CBrownUTT/American-Sign-Language-Translation-Glove/modelWrapperBLE/BLE Output Program/ASL_Signs/L.png

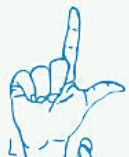
modelWrapperBLE/BLE Output Program/ASL_Signs/L.png
