CBrownUTT/American-Sign-Language-Translation-Glove/modelWrapperBLE/BLE Output Program/ASL_Signs/G.png

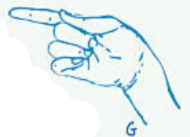
modelWrapperBLE/BLE Output Program/ASL_Signs/G.png
