CBrownUTT/American-Sign-Language-Translation-Glove/Docs/Wearable Glove for American Sign Language (ASL) Gesture Recognition - FDP.pdf

## Final Design Presentation For Wearable Glove for American Sign Language (ASL) Gesture Recognition

### Jalen Bell, Chase Brown, Jared Carrig

### Outline

1. Initial Problem & Motivation
2. Objective & Requirements
3. System Overview
4. Hardware Design
5. Software & Machine Learning
6. Design Constraints & Ethical Considerations
7. Testing Methodology
8. Results
9. Analysis
10. Limitations
11. Future Work
12. Conclusion
13. Acknowledgments
14. References

### Initial Problem & Motivation

- Sign language use is a key marker for those enculturated into a deaf community [1]
- Socioculturally distinguishes being deaf from being hard of hearing [1]
- According to a NHIS survey, 2.80% of Americans use ASL [1]
- The same survey 16.12% of Americans report little to immense trouble with hearing
- The Wearable Glove for ASL Gesture Recognition serves as an effective, low-cost solution to this marginalized group of ASL users

### Objectives & Requirements

- Design a portable prototype to function in real-time whilst identifying ASL gestures
- Integrate sensors to interact with an embedded system
- The glove should translate the ASL alphabet and numbers one through ten
- Require that the system predict gestures with > 90% accuracy
- Comply with ethical safety factors
- Battery safety
- Make predictions within 65ms
- Maintain low cost

### System Overview

- Novel use of sensors pose as a benefit to many different kinds of systems
- “Wearable Glove for American Sign Language (ASL) Gesture Recognition,” works as a solution to translating ASL for a larger audience
- Three different sensory subsystems implemented with a microcontroller using a lightweight model
- The microcontroller displays model predictions via BLE using an application

System Overview (Sensors) ● Three different sensor subsystems to

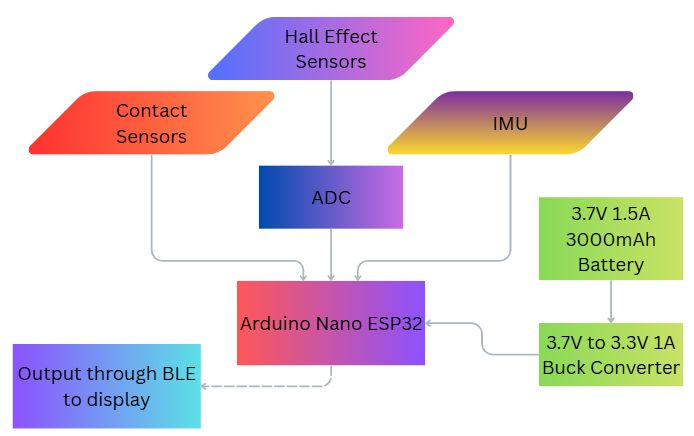
[picture p3: figure]

determine ○ Bend of the finger ○ Position of the wrist ○ Contact between finger tips

- Sensory data is acquired and handled by a microcontroller
- Performs real-time analysis of sensory data using a lightweight model
- A program interacts via BLE capabilities of the microcontroller

### Overview of Hardware Subsystems ● Contact Sensor

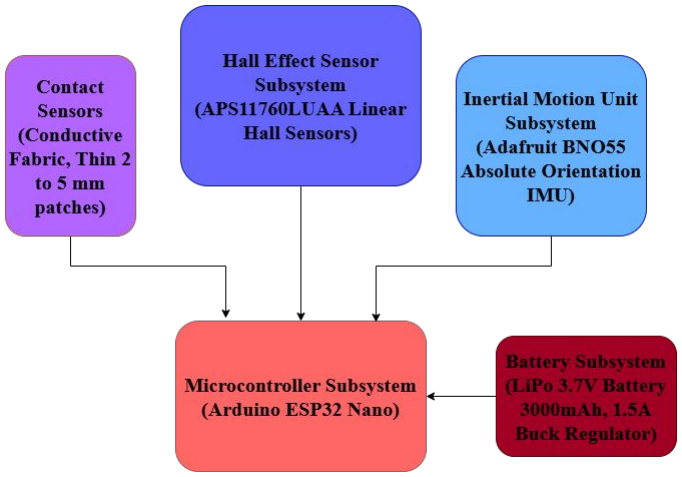
[picture p4: figure]

Subsystem
- Hall Effect Sensors
(Finger Bend)
Subsystem
- Inertial Motion Unit
Subsystem
- Microcontroller
Subsystem
- Battery/Power
Subsystem

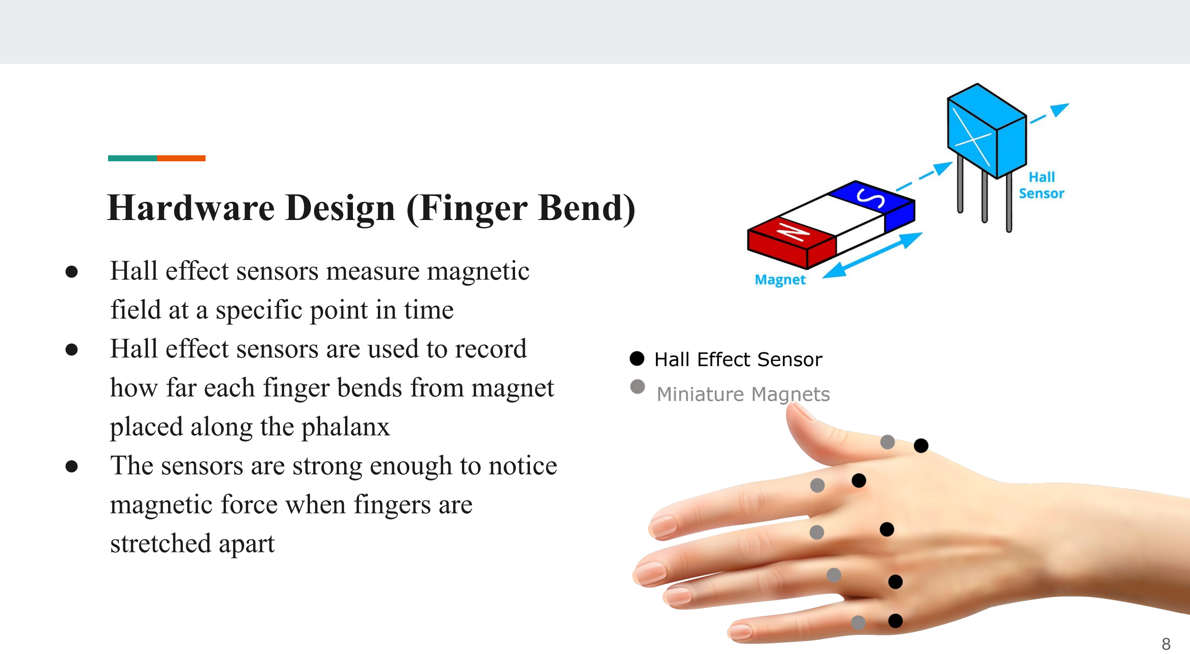
[picture p5: page 8]

### Hardware Design (Finger Bend)

- Hall effect sensors measure magnetic
field at a specific point in time
- Hall effect sensors are used to record how far each finger bends from magnet placed along the phalanx
- The sensors are strong enough to notice magnetic force when fingers are stretched apart

### Hardware Design (Contact Points)

- The glove requires that certain finger contacts to increase accuracy
- Sensors are placed along the:
- Index tip
- Middle finger tip
- Thumb (3.3V)
- Index Rear (3.3V)
- Palm
- Under the middle finger

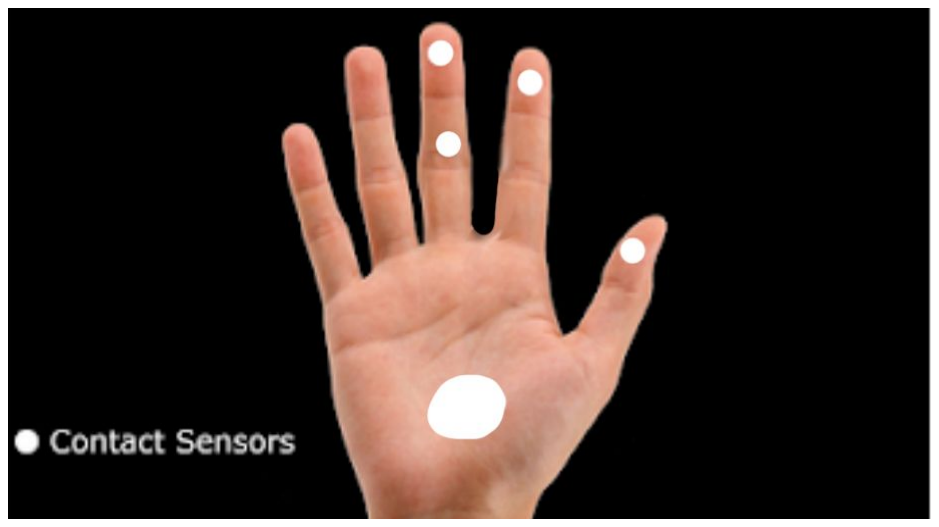
[picture p6: figure]

- Examples of gestures affected: ‘E’, ‘F’, ‘N’, ‘O’, ‘R’,

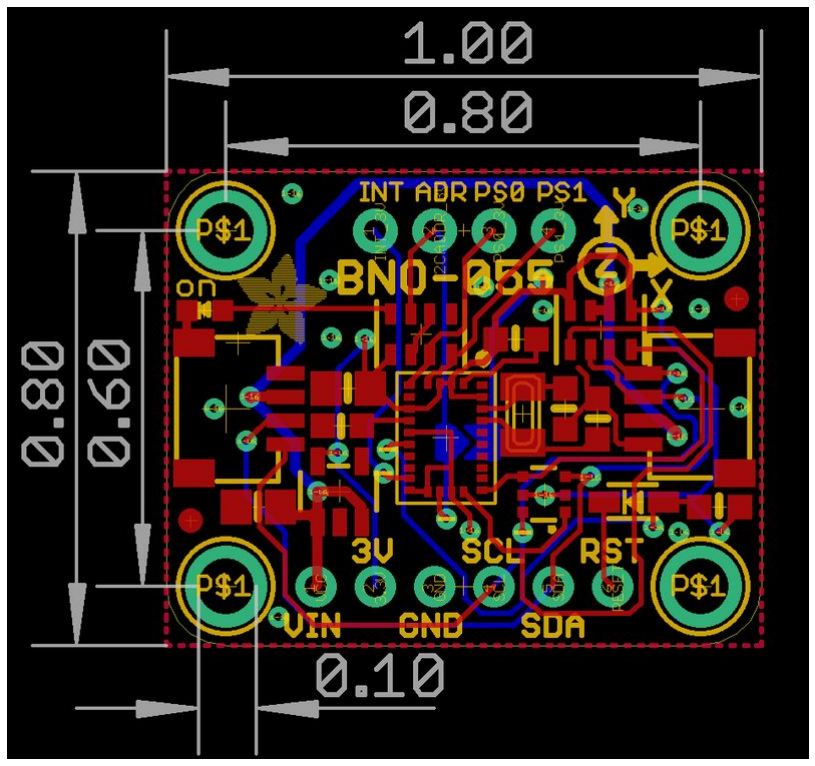
[picture p7: figure]

Hardware Design (Movement) ● | Nine Degrees of Freedom ○ | Accelerometer detects acceleration

for identifying dynamic gestures
- | Gyroscope measures orientation ■ | For example, distinguishes
| | similar gestures such as ‘V’ and ‘2’
- Magnetometer measures speed of the glove to aid in dynamic gesture recognition
- Sends data through SDA

### Power Note

- A 3.7V LiPo (3000 mAh) battery with a buck converter is used to directly power the ESP32
- Another option is powering with 5V via USB-C
- 4 - 6 hours of estimated battery life

### Evaluation of Alternatives

### - Hardware alternatives considered in Top-Level System Architecture - Considered cost, power, speed, wearability, and manufacturability - Safety/Welfare weighed higher to ensure safety of the user - Cultural factors weighed high to ensure to offense is posed to ASL users

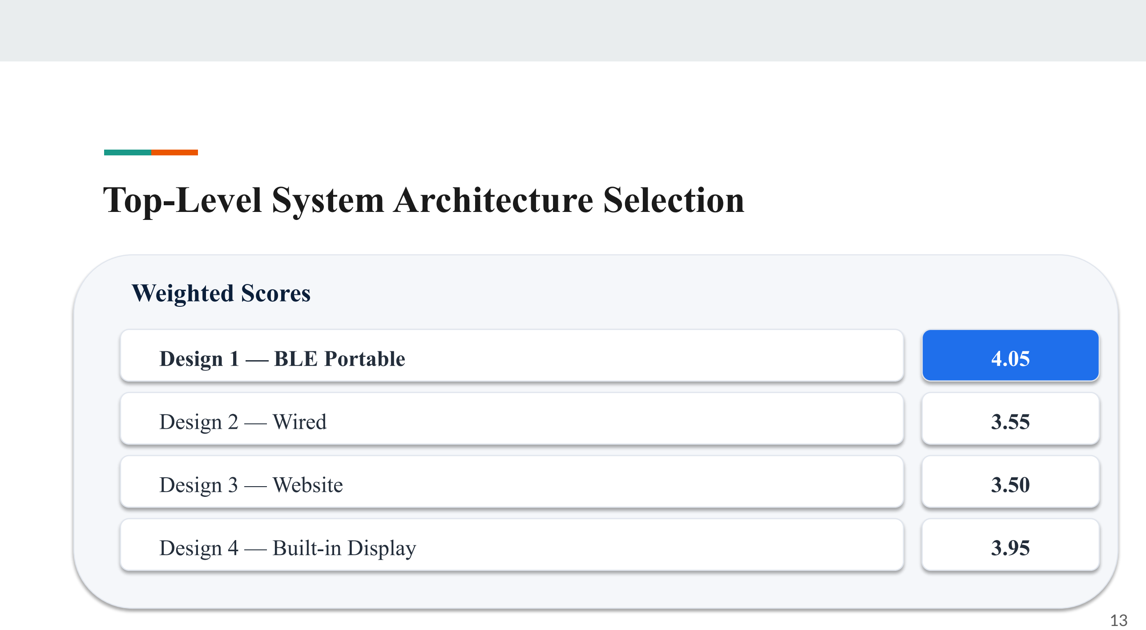
[picture p8: page 13]

### Top-Level System Architecture Selection

Weighted Scores

Design 1 — BLE Portable | 4.05
Design 2 — Wired | 3.55
Design 3 — Website | 3.50
Design 4 — Built-in Display | 3.95

### Top-Level System Architecture (cont.)

- The weighted evaluation above shows the Wearable and Portable Glove with BLE Applications maximize:
- Safety of the user
- Clear predictions of gestures
- Support for end-of-life disposal
- Minimizes cost
- Supports ASL communities
- Note: BLE applications can easily be reworked into an app that can translate into alternative languages while a display limits the translation capabilities.
- Design four has the closest score to the first design and offers a competent alternative

### Subsystem Architecture Selection

- Weighted decision matrices used to determine best component for each subsystem - Optimized on different parameters for each matrix - Microcontroller: Cost, Complexity, Compactness - Finger-bend Sensor: Accuracy, Durability - IMU: Compatibilty, Redundance - Contact Pads: Compatibility, Accessibility

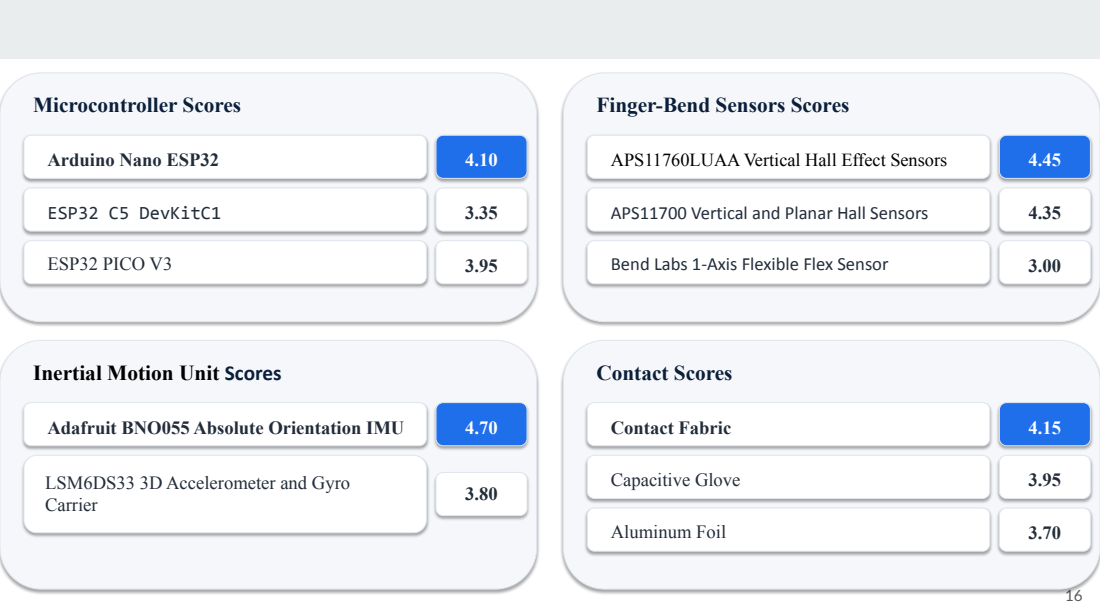
[picture p9: page 16]
Microcontroller Scores; Arduino Nano ESP32; ESP32 C5 DevKitC1; ESP32 PICO V3; Adafruit BNO055 Absolute Orientation IMU; Carrier; APS11760LUAA Vertical Hall Effect Sensors; APS11700 Vertical and Planar Hall Sensors; Bend Labs 1-Axis Flexible Flex Sensor; Contact Scores; Contact Fabric; Capacitive Glove; Aluminum Foil

Finger-Bend Sensors Scores

Inertial Motion Unit Scores

LSM6DS33 3D Accelerometer and Gyro

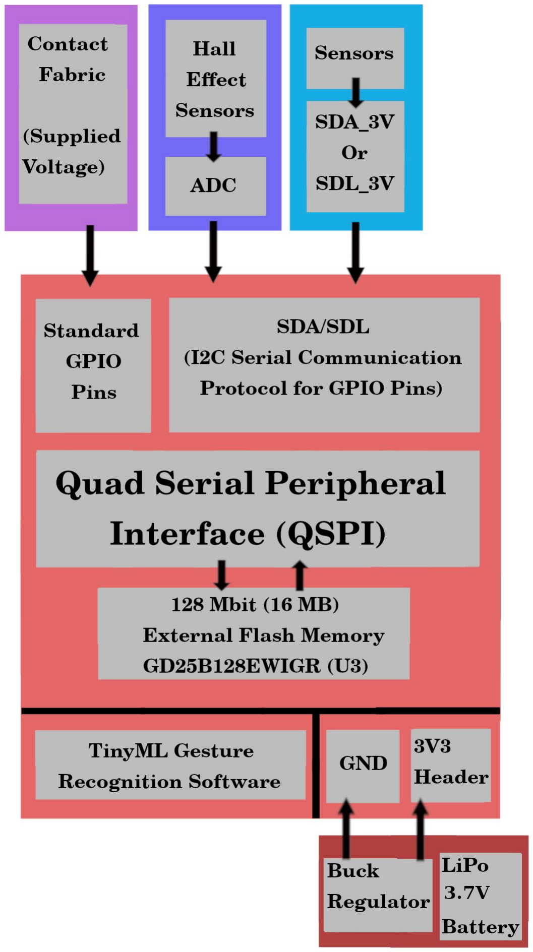
[picture p10: figure]

Hardware Block Diagram ● The hall effect sensors interact with the ADC

within their own subsystem
- The light blue represents the IMU subsystem, which interacts with its built in SDA/SDL protocols
- The flash memory on the microcontroller must interact with the Quad Serial Peripheral (QSPI)
- TinyML Gesture Recognition Software will be contained within the external flash memory

### Contact Points

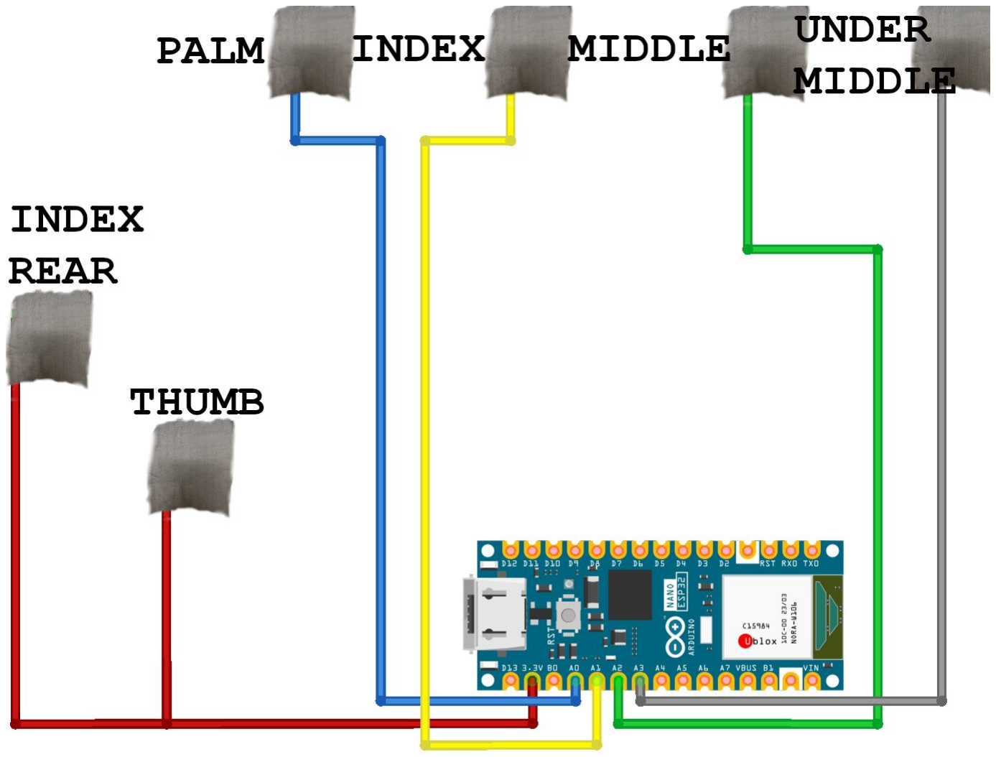
[picture p11: figure]

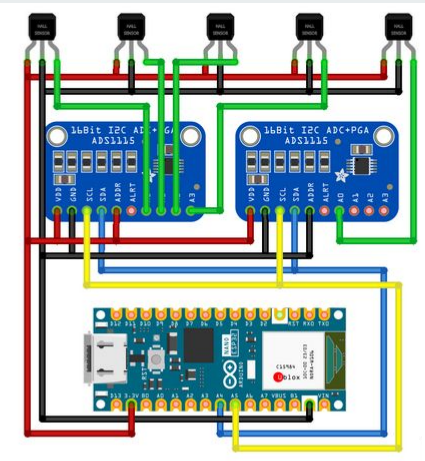
[picture p12: figure]

### Hall Effect Sensor

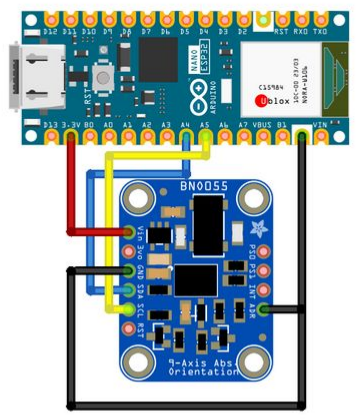
[picture p13: figure]

### Inertial Motion Unit

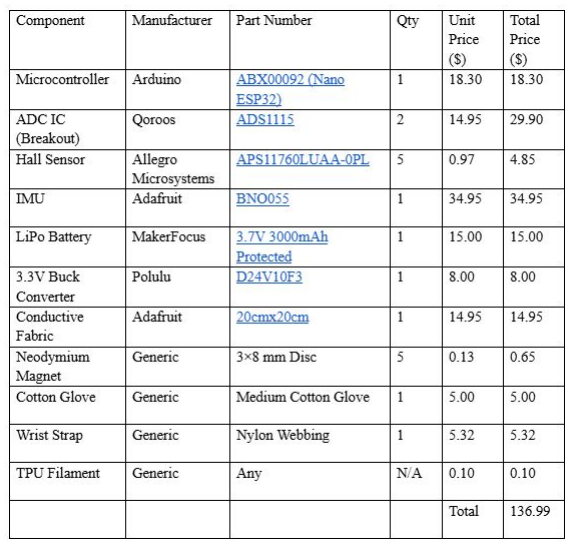
[picture p14: figure]

### Bill of Materials (High-Level)

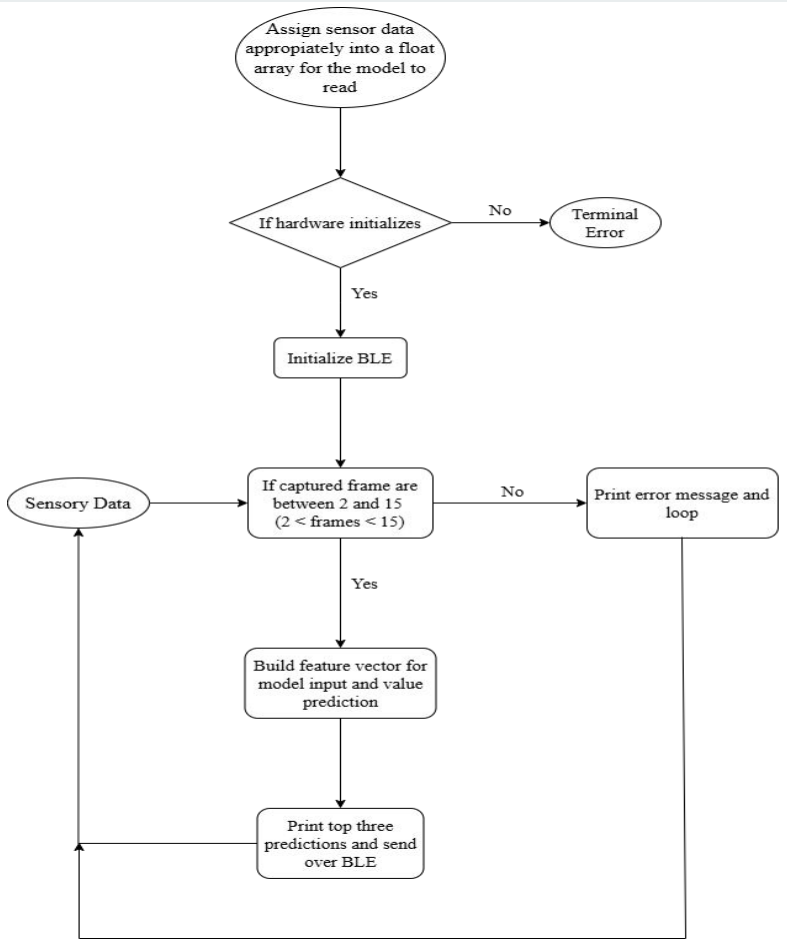
[picture p15: figure]

Software Flowchart ● Pre-Setup: ○ Assign sensor data into array ● Setup: ○ Initialize Hardware ○ Initialize BLE ● Loop: ○ Take in data and check for

appropriate frame count
- Build feature vector and have model predict
- Print predictions and send over BLE

### System Integration

- Microcontroller programmed according to software flowchart - Seperate program written for real-time data acquisition - Model is trained using data written to a “.csv” file - After conversion, model deployed to embedded system with BLE intialization - Wireless communication application receives prediction

### Deployed Model

### - Pre-Processing - Shuffled data - Trained a random forest model and decision tree model - 80 - 20 train test split - Displayed metrics for both models - Roughly 50k lines in data and 2,700 gestures signed

### Ethics

- Public health
- The prototype poses low
risk to self, low heat
- Safety and Welfare
- Insulated, nylon battery pocket protects user
- Battery life testing
- Global Factors
- Currently only affects
the US
- Scalable to other
countries
- Cultural and Social Factors
- Benefits ASL using countries
- Multi-language support for non-ASL users
- Environmental Factors
- Low risk with proper disposal
- Economic Factors
- Low-cost materials
- Cost-effective (~$150)

### Testing Methodology

- Accuracy Testing:
- Each of the 36 gestures were performed 10 times
- Stability of predictions
- Confidence of the model
- Leniencey on prediction times
- Battery life and user safety:
- Battery life measured with stopwatch
- Time to make prediction:
- Response Time = (Time of Output) - (End of Reading Time)

Experimental Results and Analysis cont.

- After model training we graphed the results of the decision tree model and random forest along with their respective F-1 scores, recall, accuracy and precision

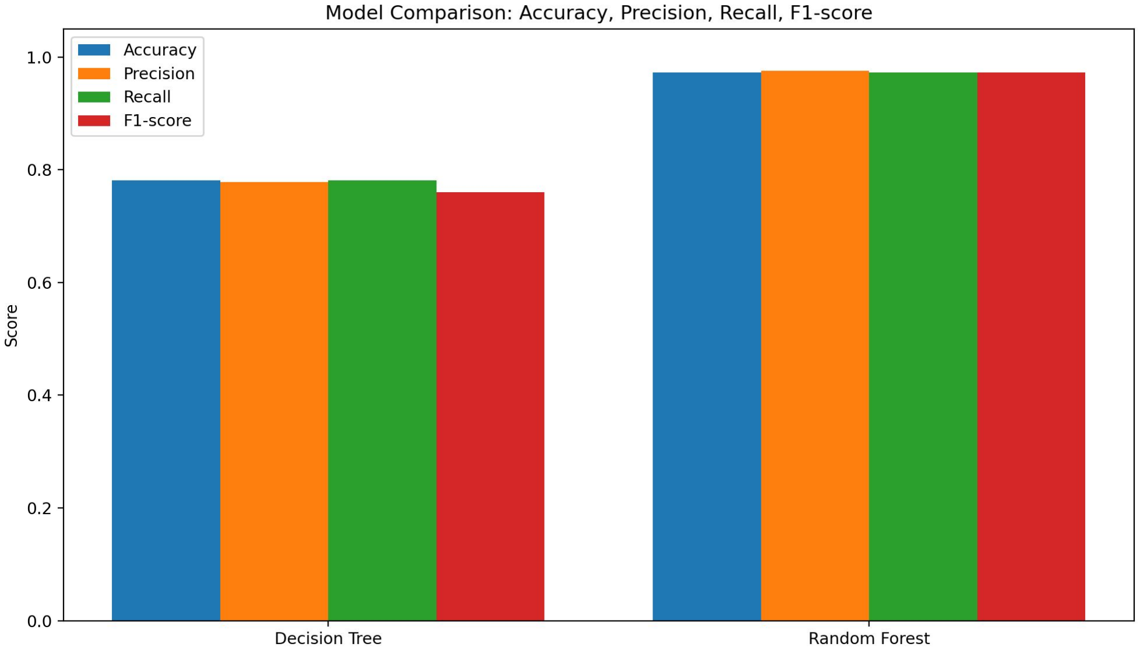
[picture p16: figure]

- Random Forest provided
better results
- Decision Tree performed
adequately, but did not
meet design specifications

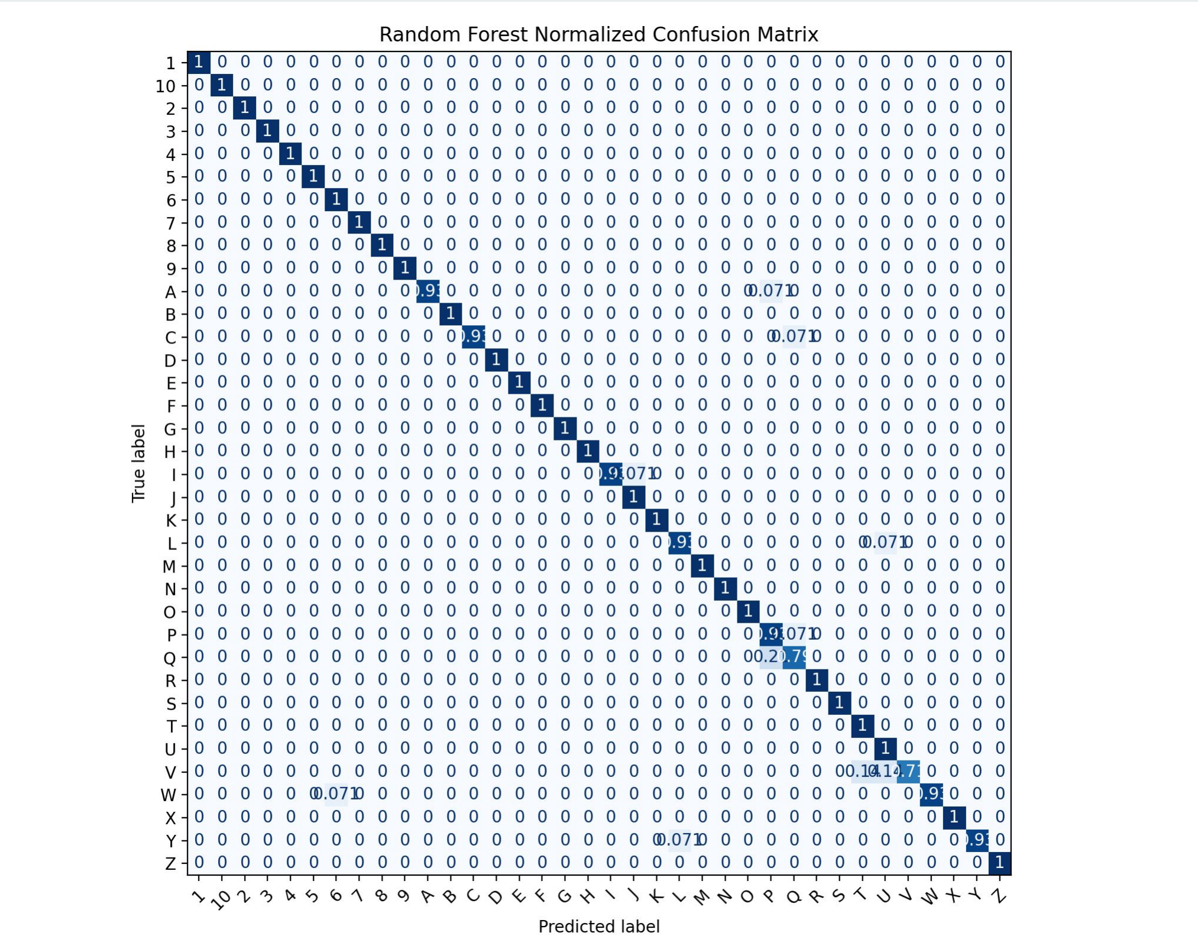
[picture p17: figure]

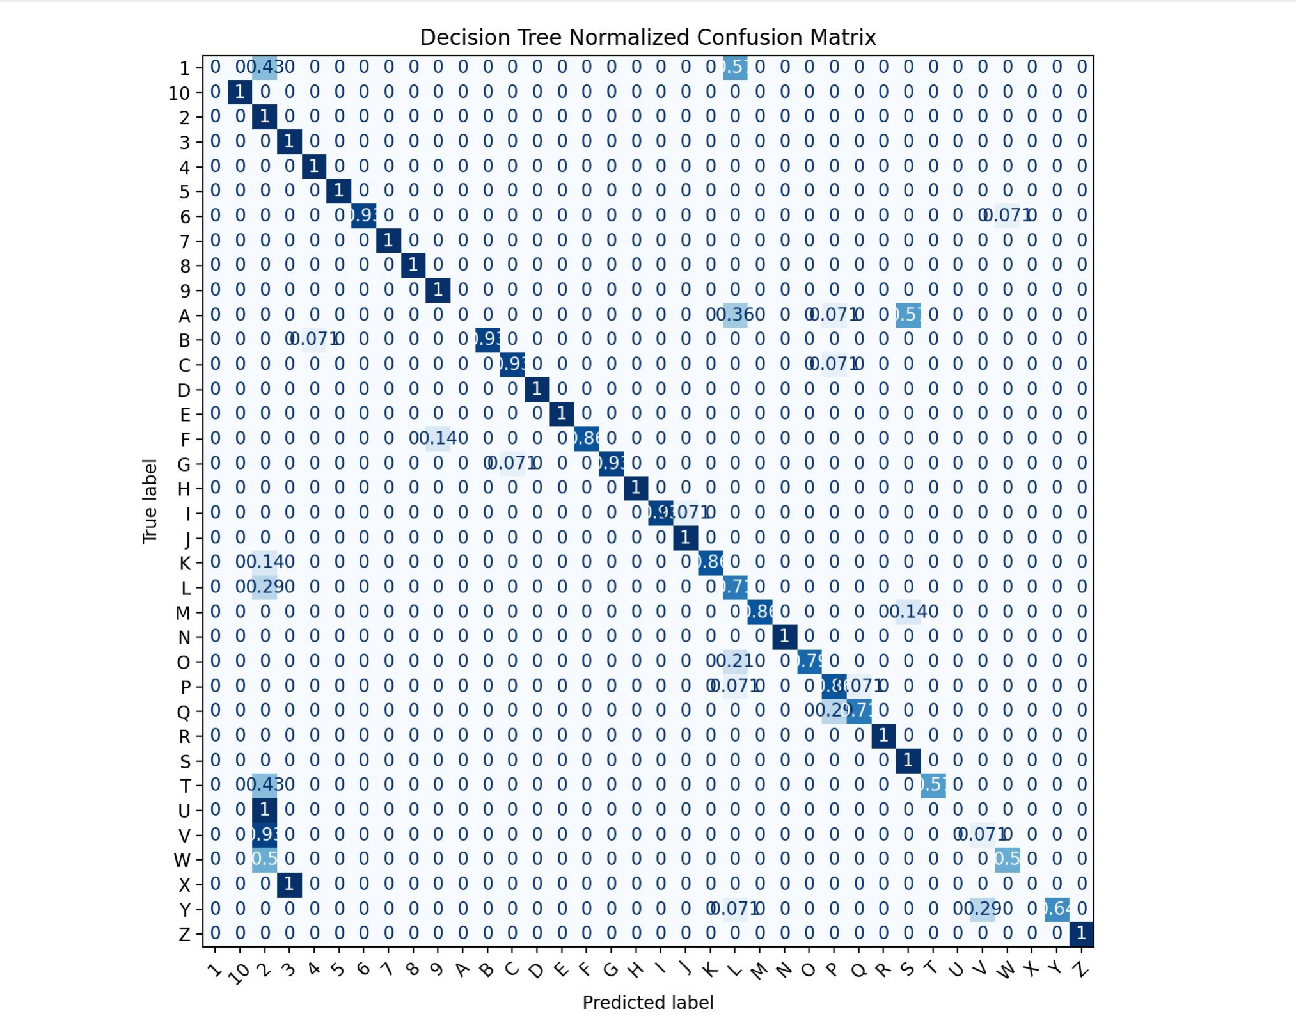
[picture p18: figure]

Experimental Results and Analysis cont. ● For decision tree,

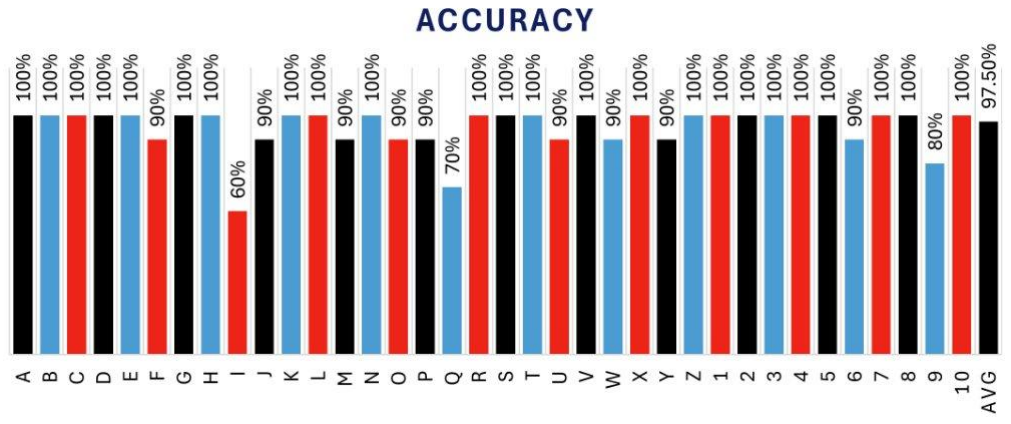
[picture p19: figure]

performance too varied
and did not meet
system requirements
- Random forest model
performs strong with
similar gestures ○ ‘Q’, ‘I’, and ‘Y’

performed weaker
than others, but
still maintained
high performance
metrics

### Broader Impacts of the Project

- Safety/Welfare and Cultural factors are expected to have the most positive influences:
- Extreme caution was maintained ensuring accuracy for cultural factors
- Readily available public sources were used to verify
- Pocket prevents heat and ensures no direct contact between battery and skin.
- Safe charging and battery chassis necessary for commercial units
- Other factors weren’t as important, but can still expect positive influences:
- The glove is cost effective to produce
- $150 to produce each unit
- The glove uses minimal electronics that will have a minimal environmental impact if disposed of properly

### Future Work

- Full word gesture recognition
- Duplicate the glove to the left hand and estimate relative spatial position to the users’ body
- Requires replacement of the microcontroller to allow for even connection on both hands (Perhaps back or chest)
- Multi-Language support
- Train on different data and change the glove slightly
- Some sign languages may not use the index as much as american sign language
- Further work can be achieved with further testing and time

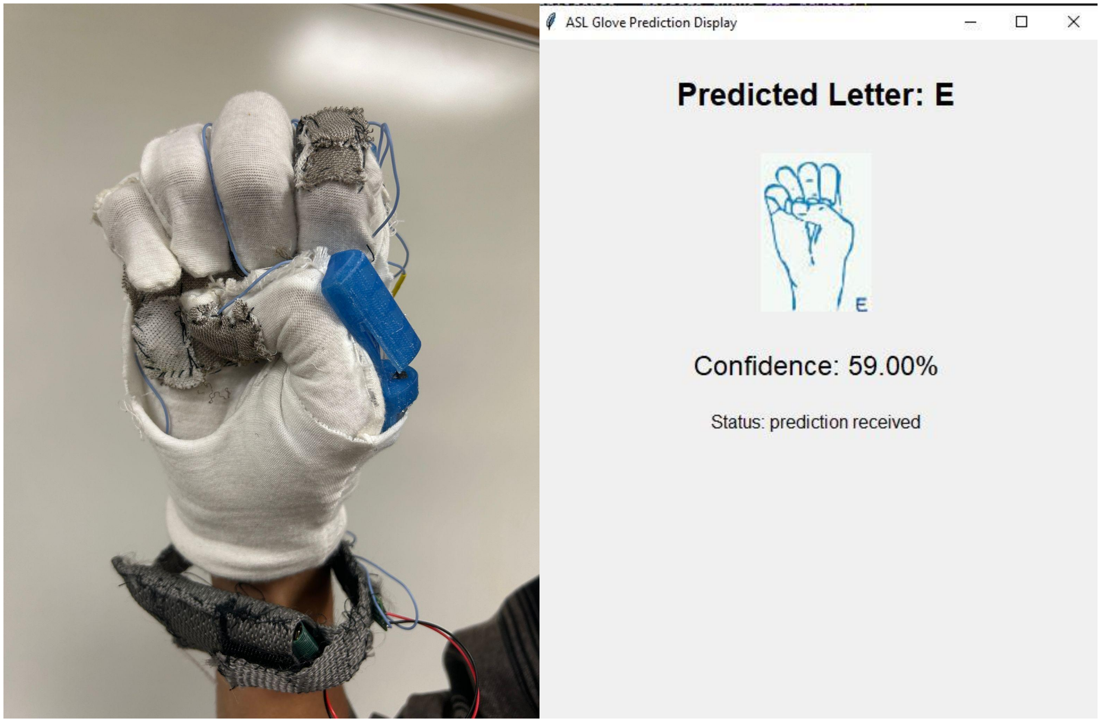
[picture p20: figure]

### Conclusion

- Developed real-time prototype ● Achieves an accuracy of

97.50% and maintains health and safety with adequate
battery life
- The glove was designed with long product life in mind
- Compact and efficient

### Acknowledgements

- Thank you Dr. Rizk for assisting us with the design process and to enhance our reports and presentations.
- Thank you UTTyler for providing lab space for the creation of our prototype and the testing of the prototype

## References

[1] Mitchell, Ross & Young, Travas. (2022). How Many People Use Sign Language? A National Health Survey-Based Estimate.

Q&A
