CBrownUTT/American-Sign-Language-Translation-Glove/Data_Aquisition/training_outputs/decision_tree_confidence_histogram.png

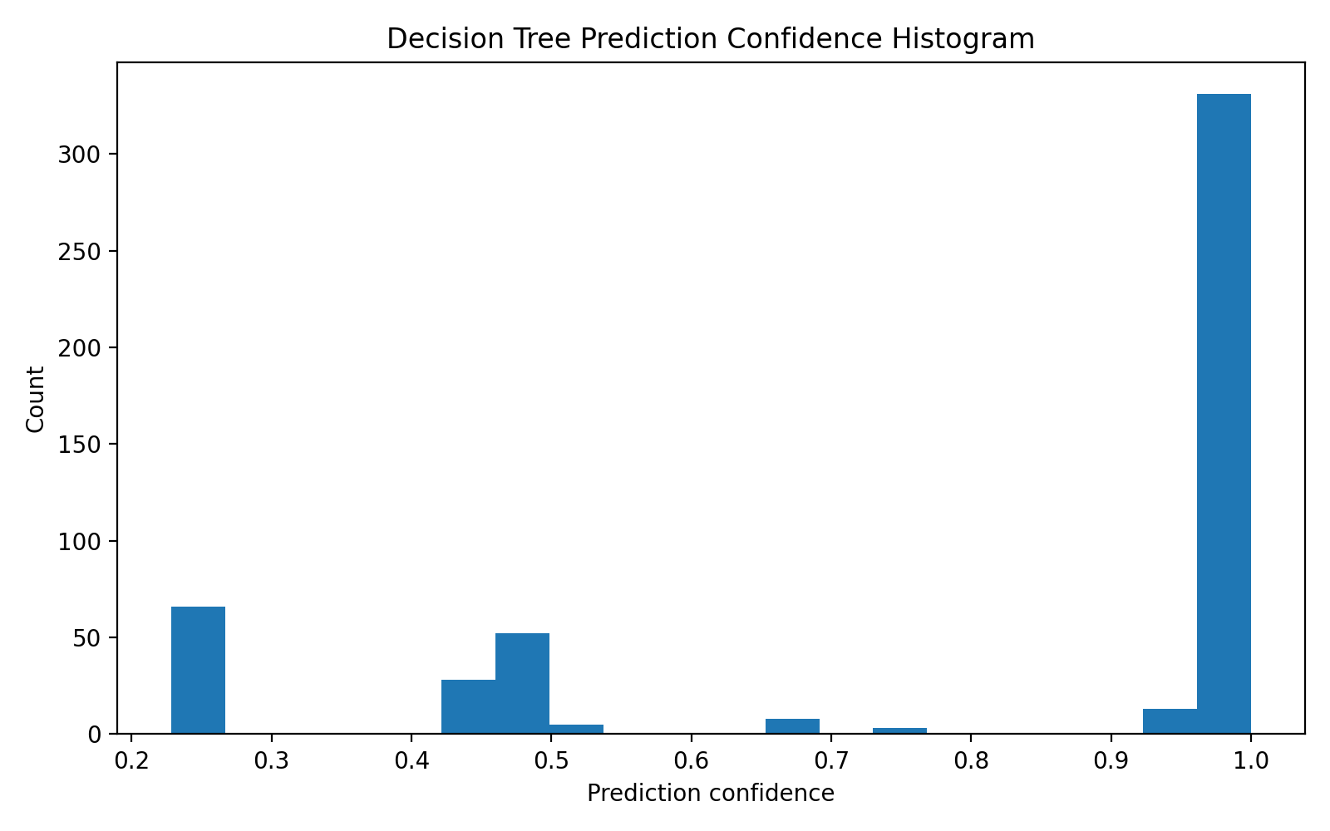
Data_Aquisition/training_outputs/decision_tree_confidence_histogram.png
