CBrownUTT/American-Sign-Language-Translation-Glove/Data_Aquisition/training_outputs/decision_tree_confusion_matrix.png

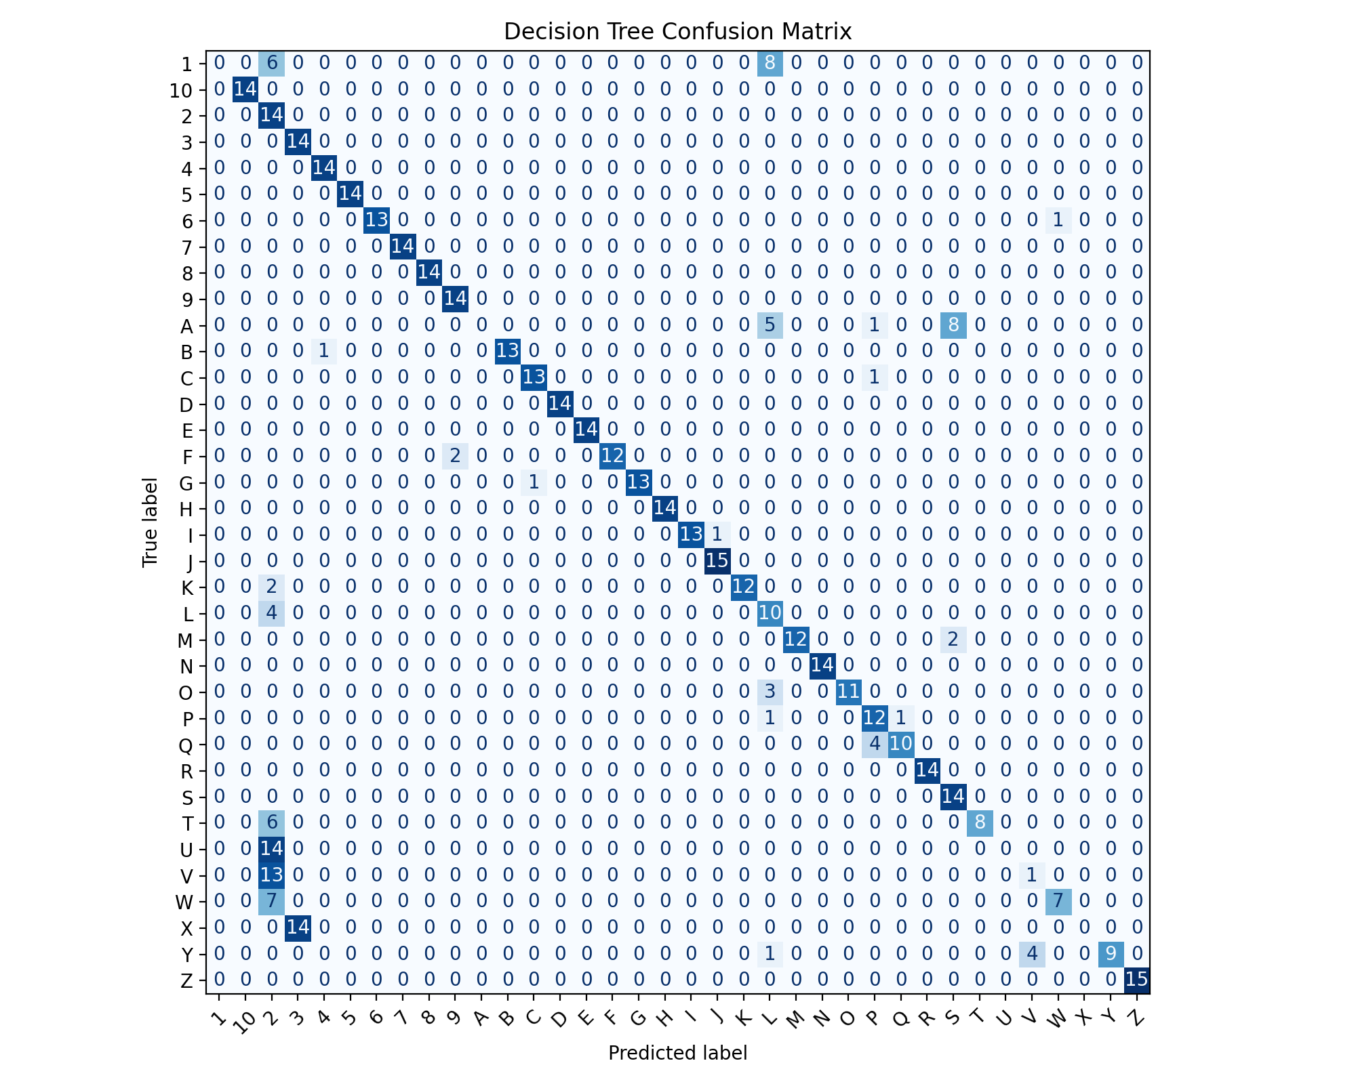
Data_Aquisition/training_outputs/decision_tree_confusion_matrix.png
