CBrownUTT/American-Sign-Language-Translation-Glove/Data_Aquisition/training_outputs/decision_tree_feature_importances.png

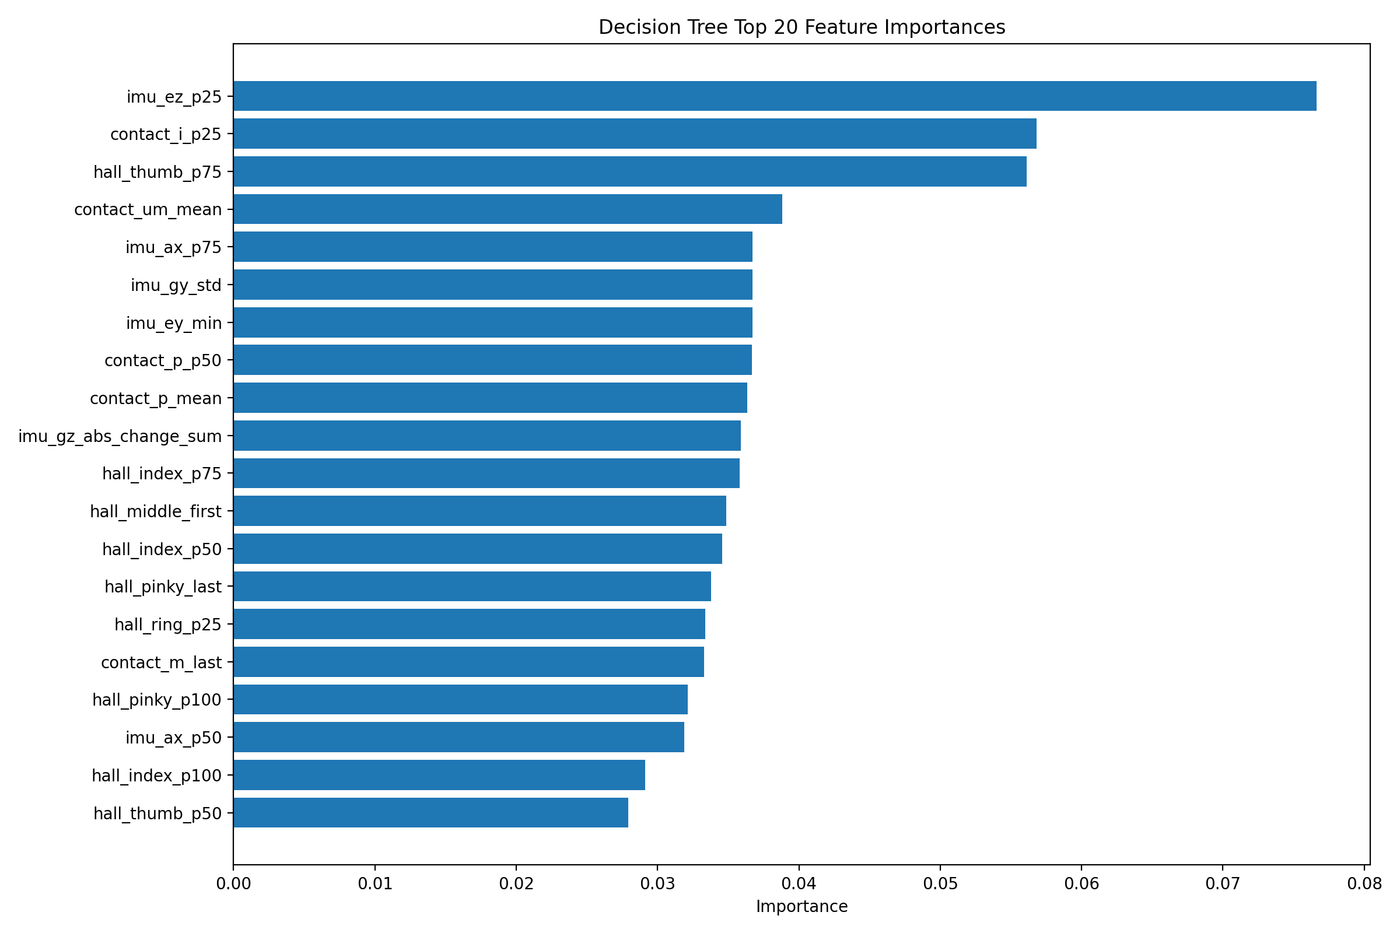
Data_Aquisition/training_outputs/decision_tree_feature_importances.png
