CBrownUTT/American-Sign-Language-Translation-Glove/Data_Aquisition/training_outputs/random_forest_confidence_histogram.png

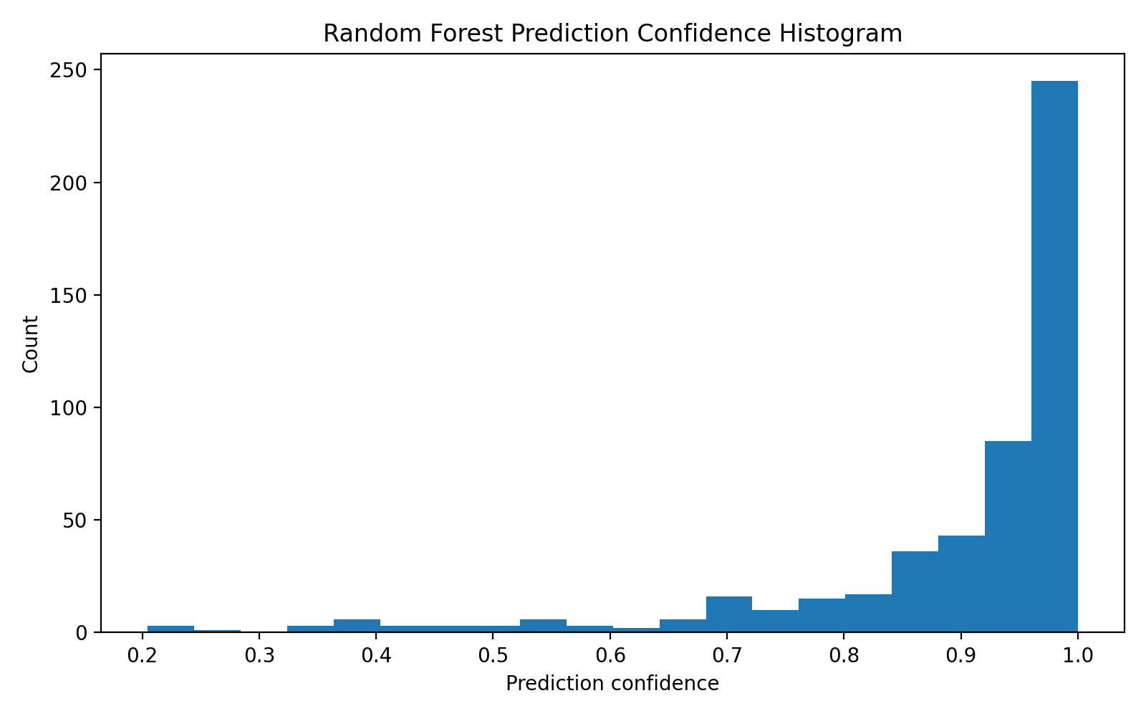
Data_Aquisition/training_outputs/random_forest_confidence_histogram.png
