CBrownUTT/American-Sign-Language-Translation-Glove/Data_Aquisition/training_outputs/random_forest_feature_importances.png

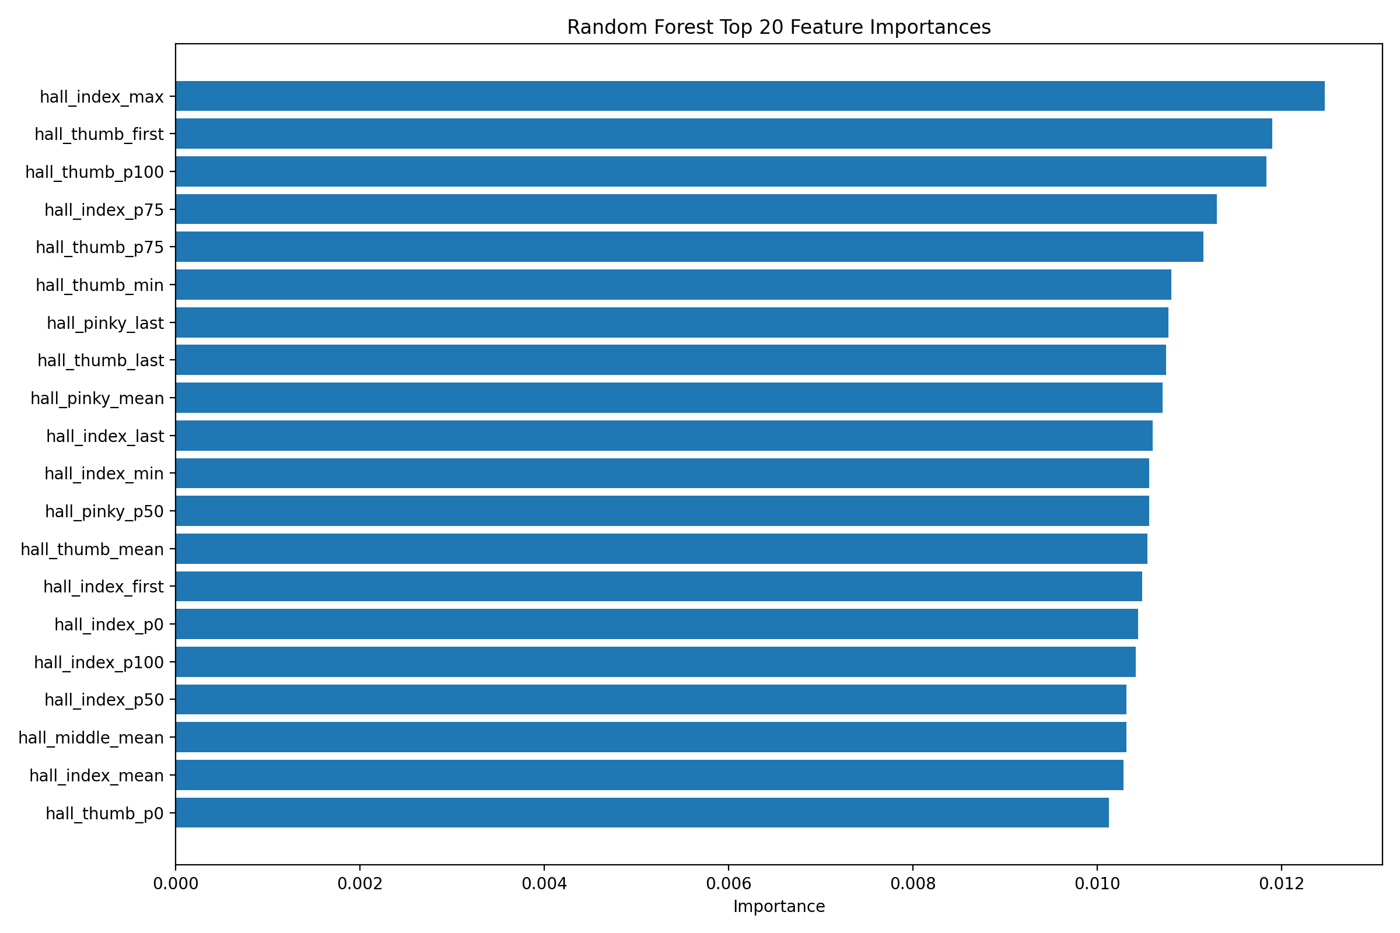
Data_Aquisition/training_outputs/random_forest_feature_importances.png
