CBrownUTT/American-Sign-Language-Translation-Glove/modelWrapperBLE/BLE Output Program/ASL_Signs/5.png

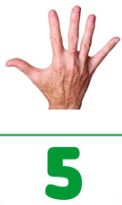
modelWrapperBLE/BLE Output Program/ASL_Signs/5.png
