CBrownUTT/American-Sign-Language-Translation-Glove/modelWrapperBLE/BLE Output Program/ASL_Signs/H.png

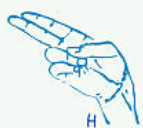
modelWrapperBLE/BLE Output Program/ASL_Signs/H.png
