CBrownUTT/American-Sign-Language-Translation-Glove/modelWrapperBLE/BLE Output Program/ASL_Signs/Y.png

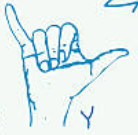
modelWrapperBLE/BLE Output Program/ASL_Signs/Y.png
