CBrownUTT/American-Sign-Language-Translation-Glove/modelWrapperBLE/BLE Output Program/ASL_Signs/Z.png

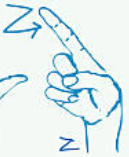
modelWrapperBLE/BLE Output Program/ASL_Signs/Z.png
