CBrownUTT/American-Sign-Language-Translation-Glove/(commit log)

2026-04-15 Add files via upload
    uploaded the final versions of the prototype including the final data set, model, and performance metrics
2026-04-15 Deleted glove_sequence_data.csv since it is not used
    [glove_sequence_data.csv]
